h4xxel/sensys/project/rp/block.pdf

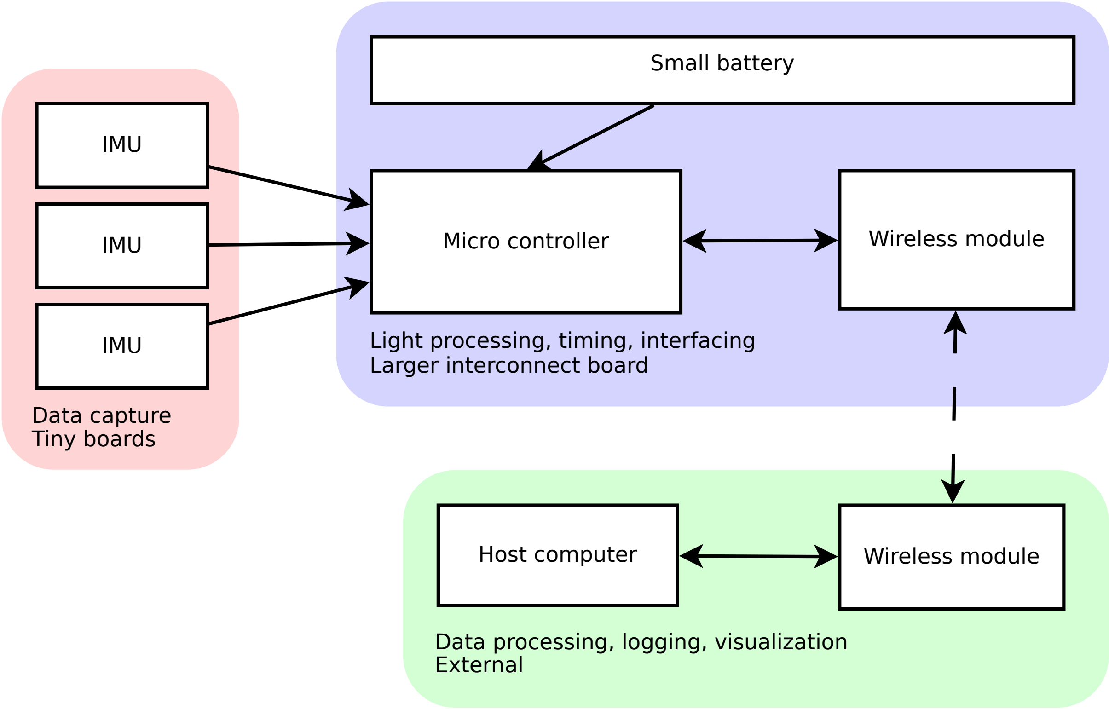
[picture p2: figure]
Host computer; Wireless module; Micro controller; IMU; Light processing, timing, interfacing; Data processing, logging, visualization; Data capture Tiny boards; Larger interconnect board; External; Small battery
