h4xxel/sensys/project/rp/fast_continuous.pdf

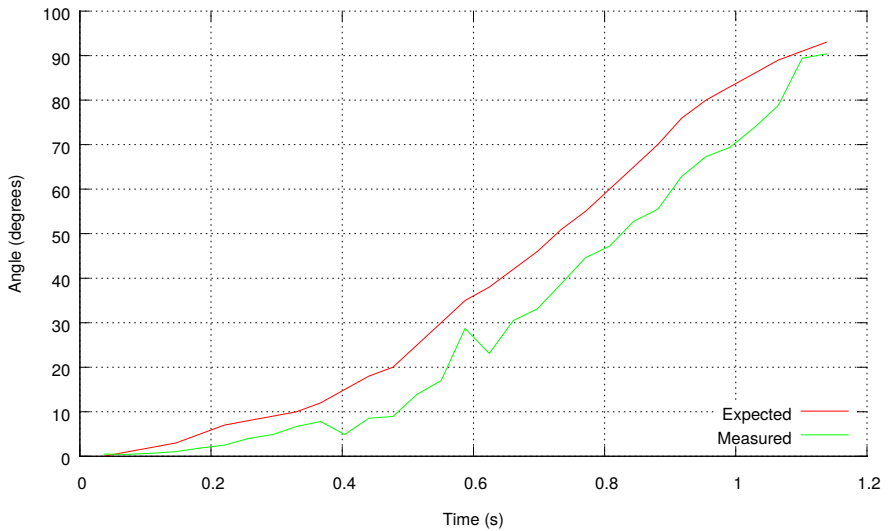
[picture p3: figure]
Angle (degrees); Time (s); Expected Measured
