h4xxel/sensys/project/rp/drift-test.txt

0: 2.754109, -5.791414, 1.912900
1: -2.135889, 3.678494, 3.380230
0: 3.484197, -5.737147, 0.786157
1: -2.248333, 3.543522, 8.210700
0: 3.324079, -6.429792, 2.592853
1: -1.999125, 3.940541, 8.957793
0: 3.663577, -6.534390, 3.165380
1: -2.439009, 4.077634, 16.534928
0: 3.523671, -6.586199, 3.595080
1: -2.739936, 4.635099, 22.509232
0: 4.181078, -6.275802, 4.041871
1: -3.190197, 4.027050, 18.898282
0: 3.587332, -6.578981, 8.183844
1: -2.313665, 4.399825, 36.857814
0: 3.763462, -6.266907, 9.407025
1: -2.519014, 4.058138, 40.708029
0: 4.041102, -6.453749, 13.049715
1: -2.561985, 4.053509, 41.313517
0: 4.044861, -6.879364, 14.176458
1: -2.894771, 4.844525, 46.248970
0: 4.060049, -6.381956, 18.270821
1: -3.555296, 4.817330, 49.063997
0: 3.740158, -7.006330, 14.310739
1: -2.608455, 4.893282, 51.717887
0: 4.591976, -6.848918, 21.376385
1: -4.256651, 4.655012, 51.041597
0: 3.910754, -7.464783, 22.722861
1: -3.404457, 5.141975, 51.788690
0: 4.214629, -6.475833, 24.950713
1: -4.033663, 3.994383, 51.944945
0: 4.015381, -6.854883, 29.198889
1: -3.103940, 4.664240, 43.468123
0: 3.746579, -7.061296, 31.819819
1: -2.875613, 4.813496, 30.856655
0: 4.352792, -6.191790, 39.698477
1: -3.066321, 3.819444, 25.315714
0: 3.803965, -6.847050, 44.513077
1: -3.302875, 4.025819, 26.403394
0: 4.499173, -6.910906, 46.259957
1: -4.105956, 4.755221, 25.305948
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
