h4xxel/sensys/project/pi/testbone.txt

0.24 0.12: 3 0, 3 0, 3 0, -1 0
0.24 0.12: 3 0, 3 0, 3 0, 0 1
