h4xxel/sensys/project/rp/drift.pdf

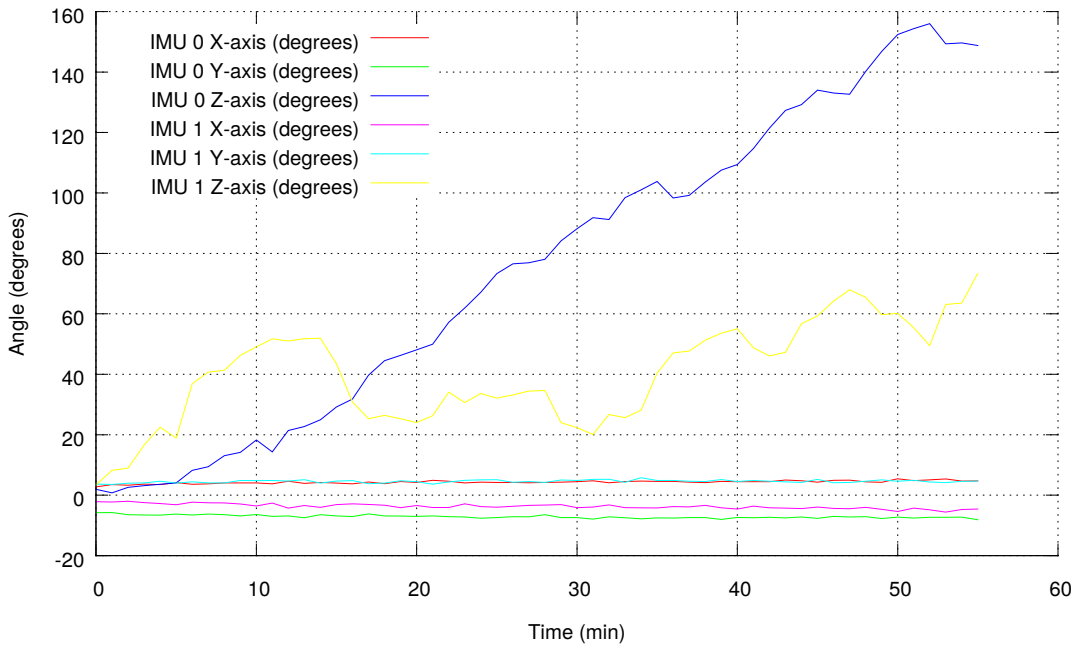
[picture p4: page 1]
Angle (degrees); Time (min)

IMU 0 X-axis (degrees)
IMU 0 Y-axis (degrees)
IMU 0 Z-axis (degrees)
IMU 1 X-axis (degrees)
IMU 1 Y-axis (degrees)
IMU 1 Z-axis (degrees)
