h4xxel/sensys/project/rp/mb_schematic.pdf

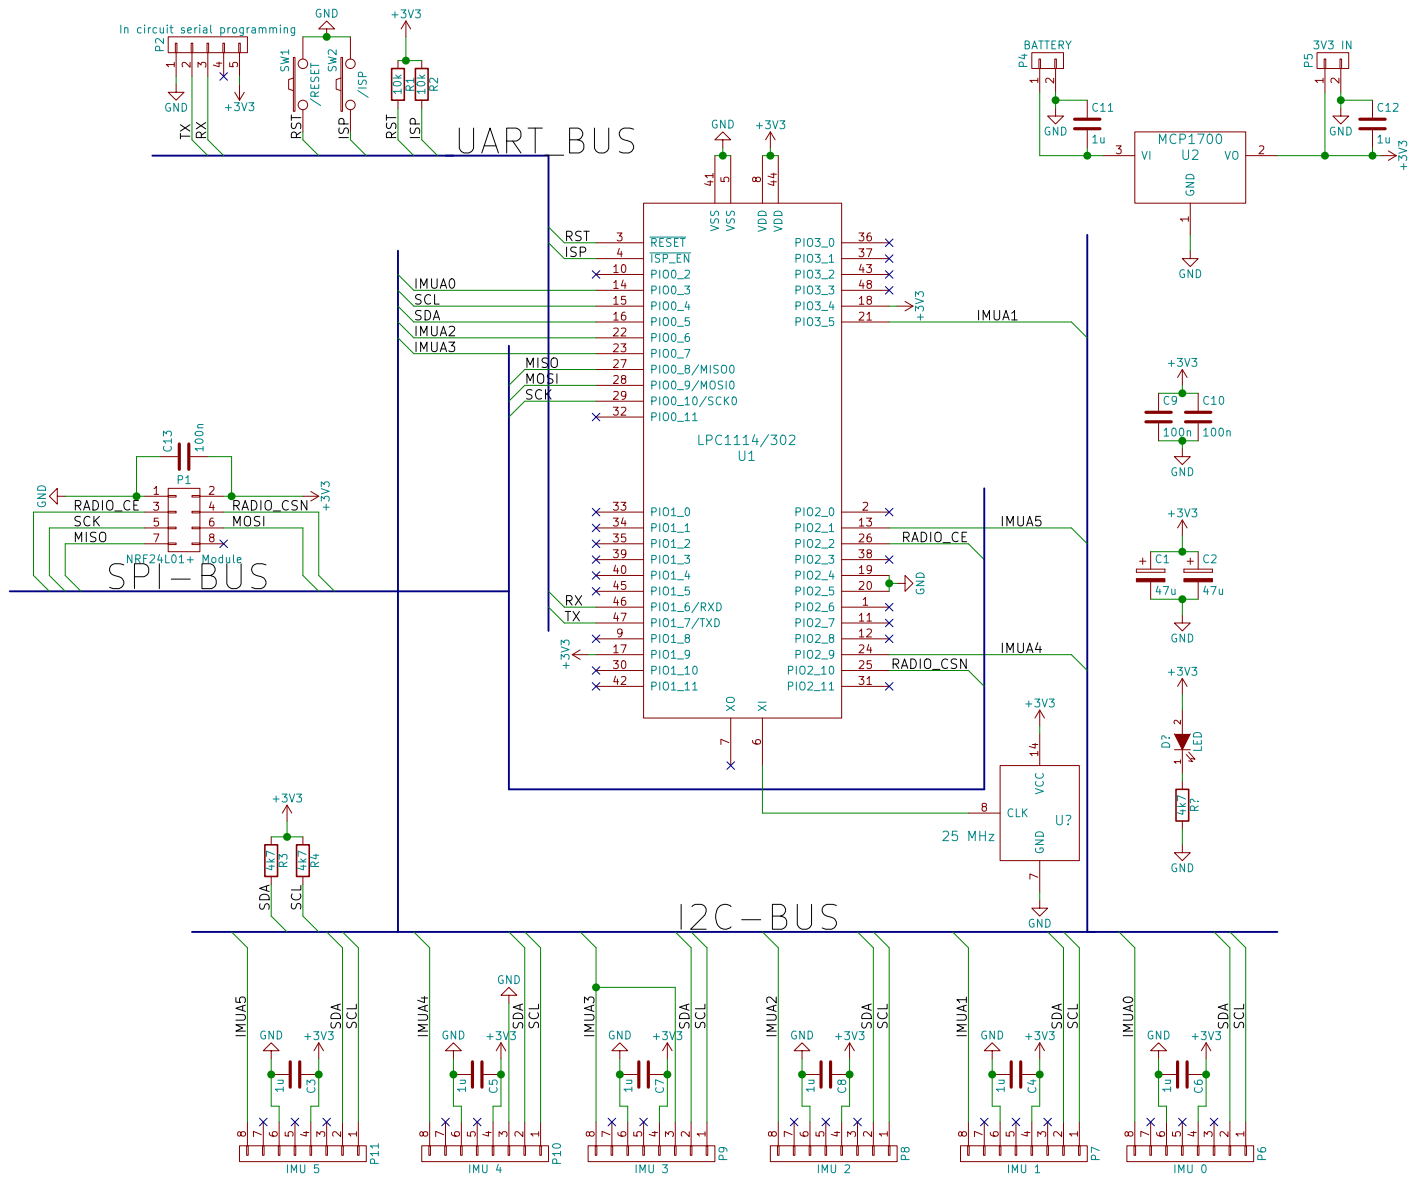
[picture p5: page 1]
