h4xxel/sensys/project/rp/imu_schematic.pdf

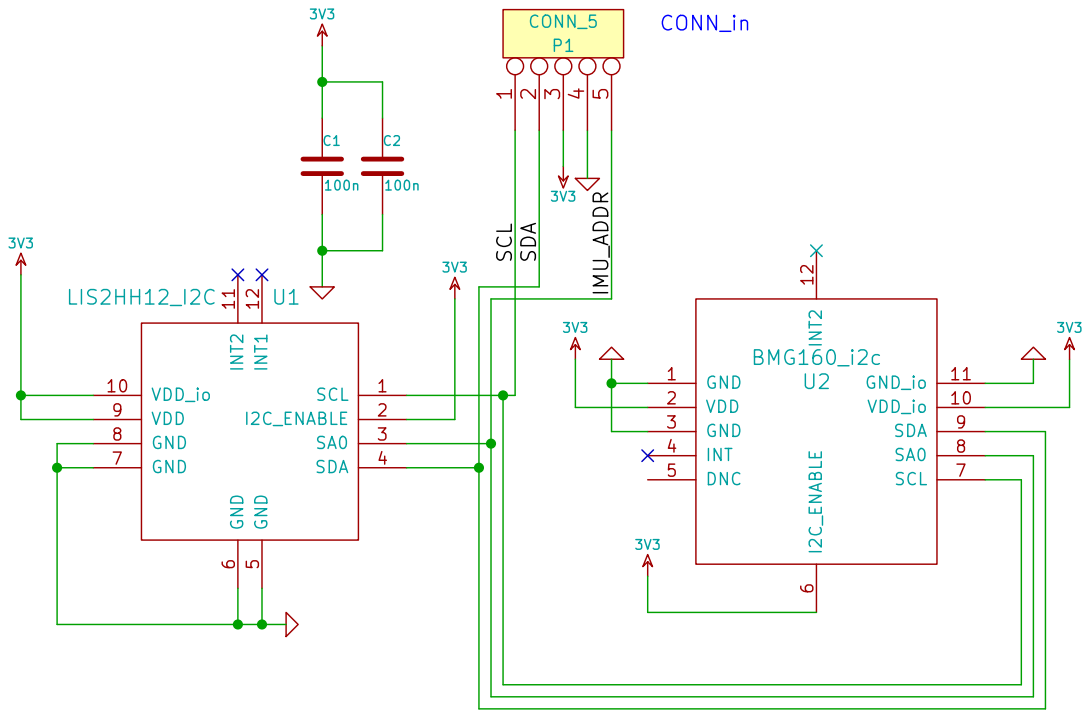
[picture p6: page 1]
