h4xxel/sensys/project/rp/micro-eps-converted-to.pdf

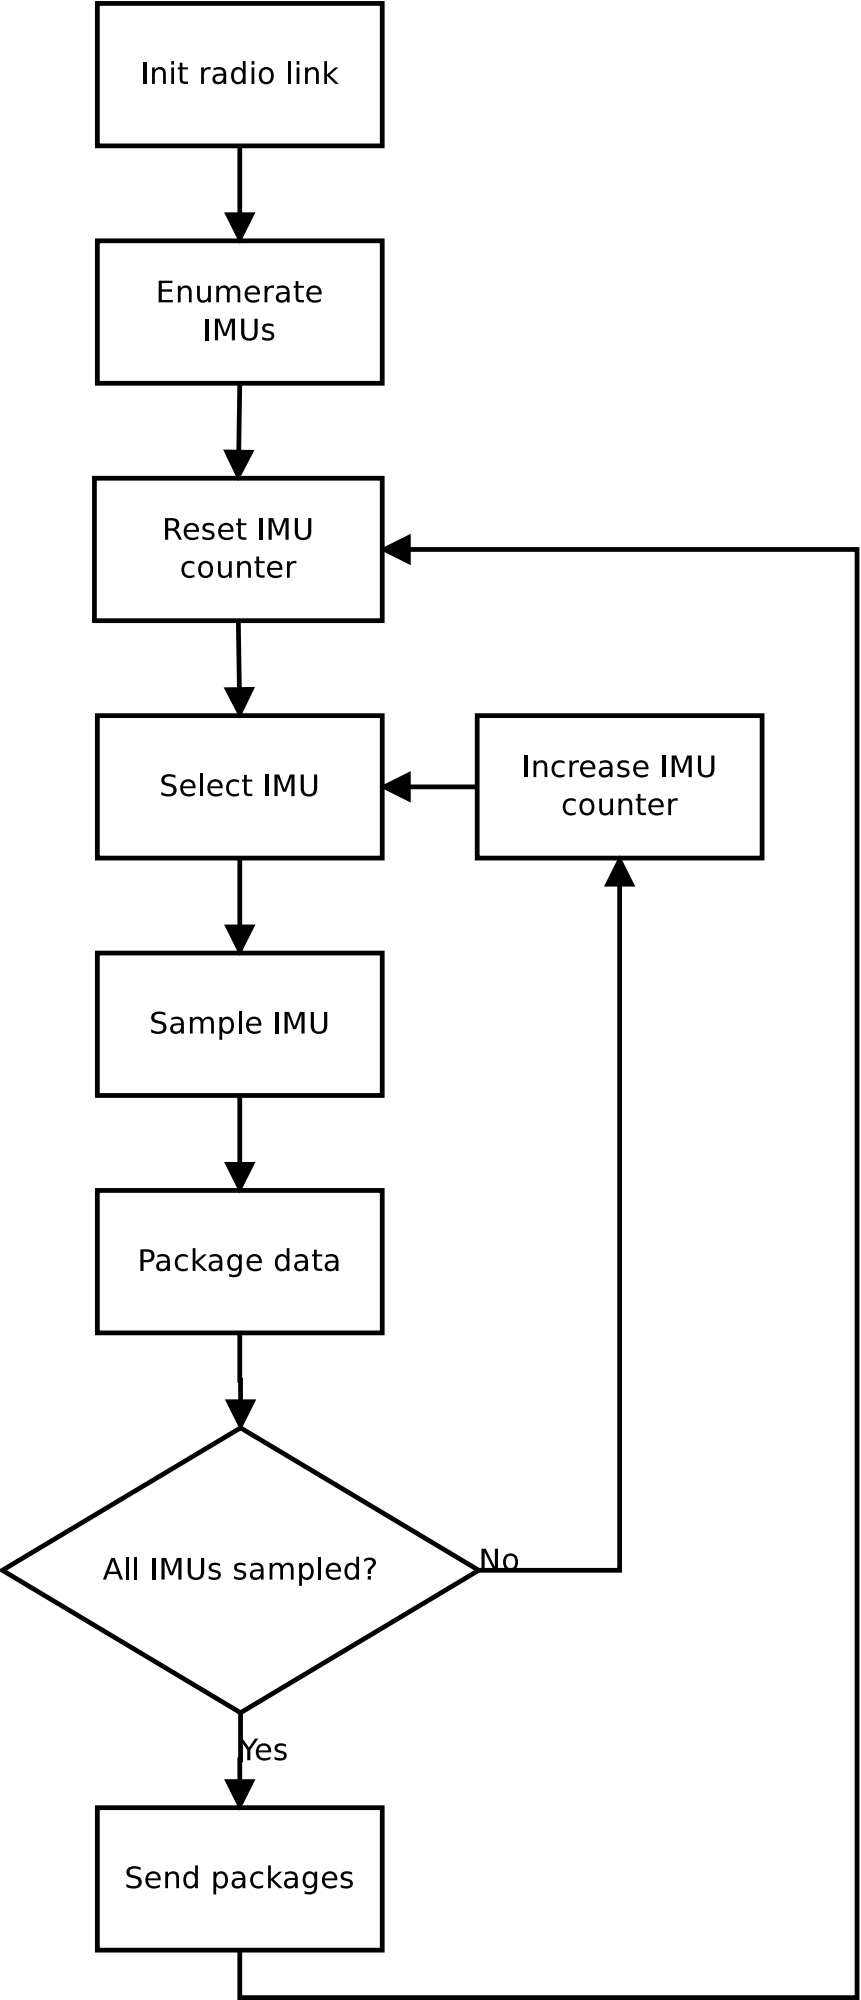
[picture p7: page 1]
