h4xxel/sensys/project/rp/pi-eps-converted-to.pdf

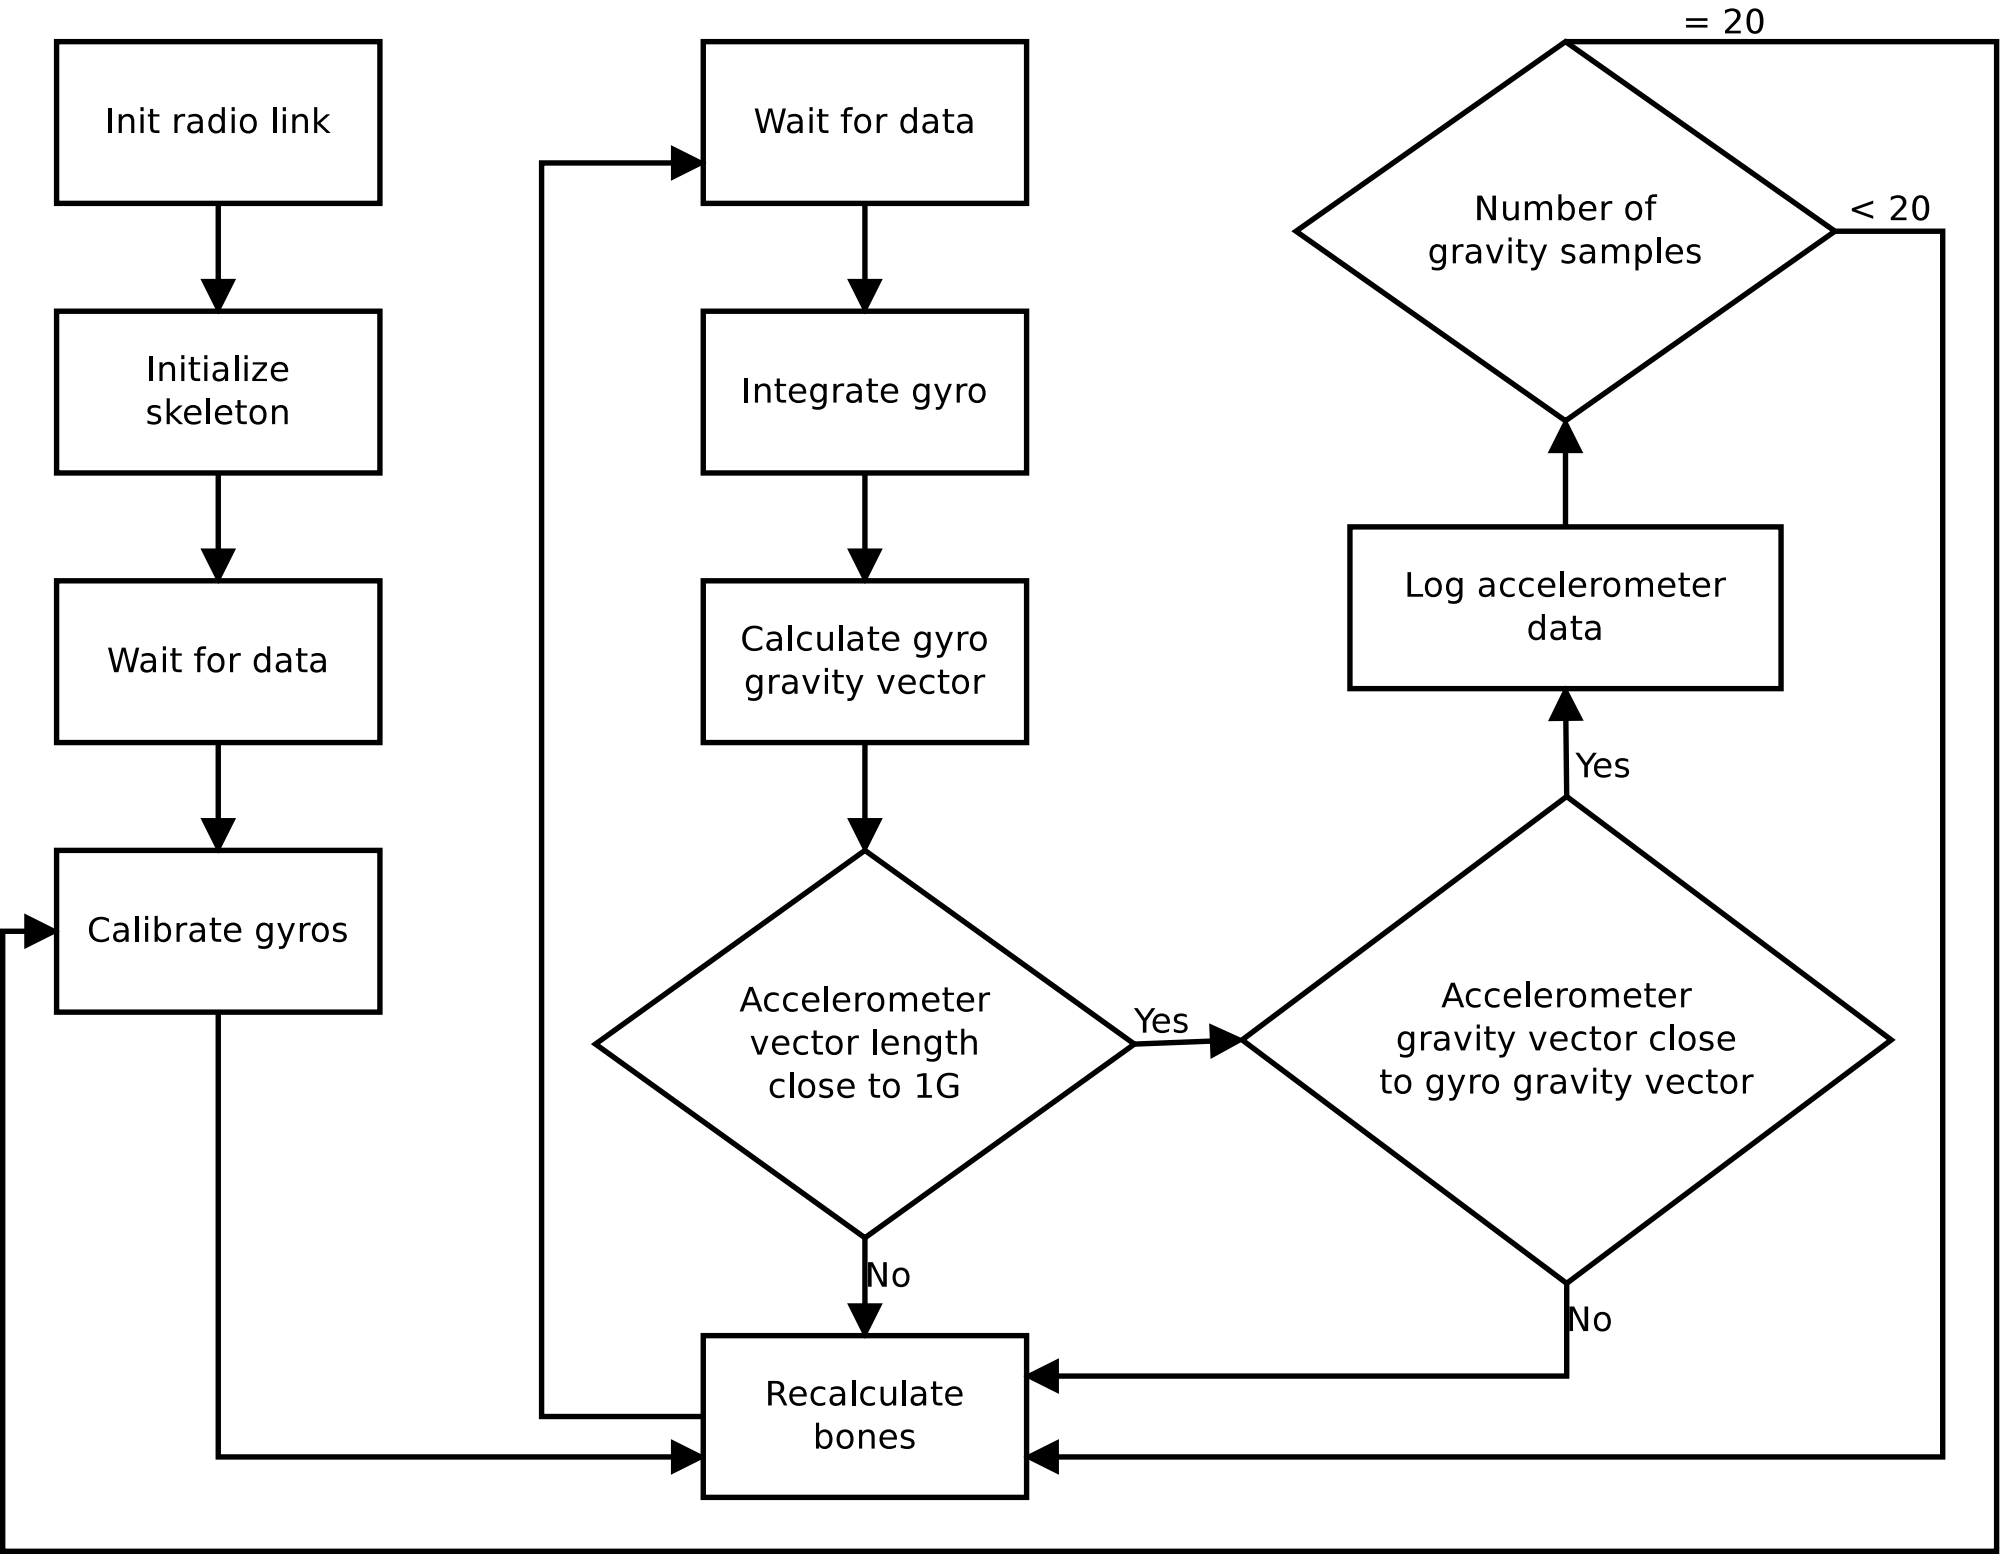
[picture p8: page 1]
