h4xxel/sensys/project/rp/stepped.pdf

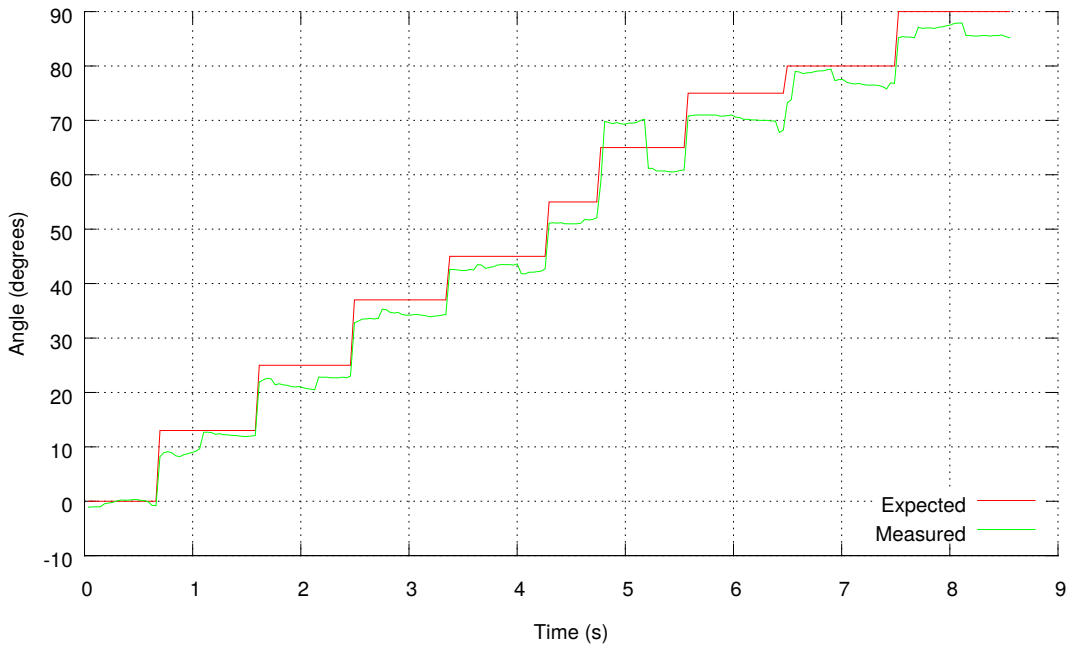
[picture p9: page 1]
Angle (degrees); Time (s); Expected Measured
