h4xxel/sensys/project/hw/imu/imu.kicad_pcb

## KiCad design project/hw/imu/imu.kicad_pcb (2015-12-17)

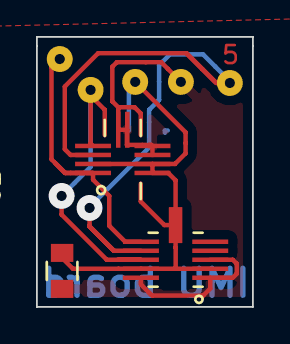
[picture p10: board imu.kicad_pcb from above]

Board: 2 copper layers, 12.0 x 15.0 mm, 5 parts (1 on the bottom side), 5 nets.

Parts:
C1, C2: 100n; C_0805
P1: CONN_5; Pin_Header_Straight_1x05
U1: LIS2HH12_I2C; LGA4x2
U2: BMG160_i2c; LGA5x1

Connections:
3V3: C1.1, C2.1, P1.3, U1.2, U1.9, U1.10, U2.2, U2.6, U2.10
GND: C1.2, C2.2, P1.4, U1.5, U1.6, U1.7, U1.8, U2.1, U2.3, U2.11
unnamed: P1.1, U1.1, U2.7
unnamed: P1.2, U1.4, U2.9
unnamed: P1.5, U1.3, U2.8
