h4xxel/sensys/project/hw/mb/mb.kicad_pcb

## KiCad design project/hw/mb/mb.kicad_pcb (2015-12-15)

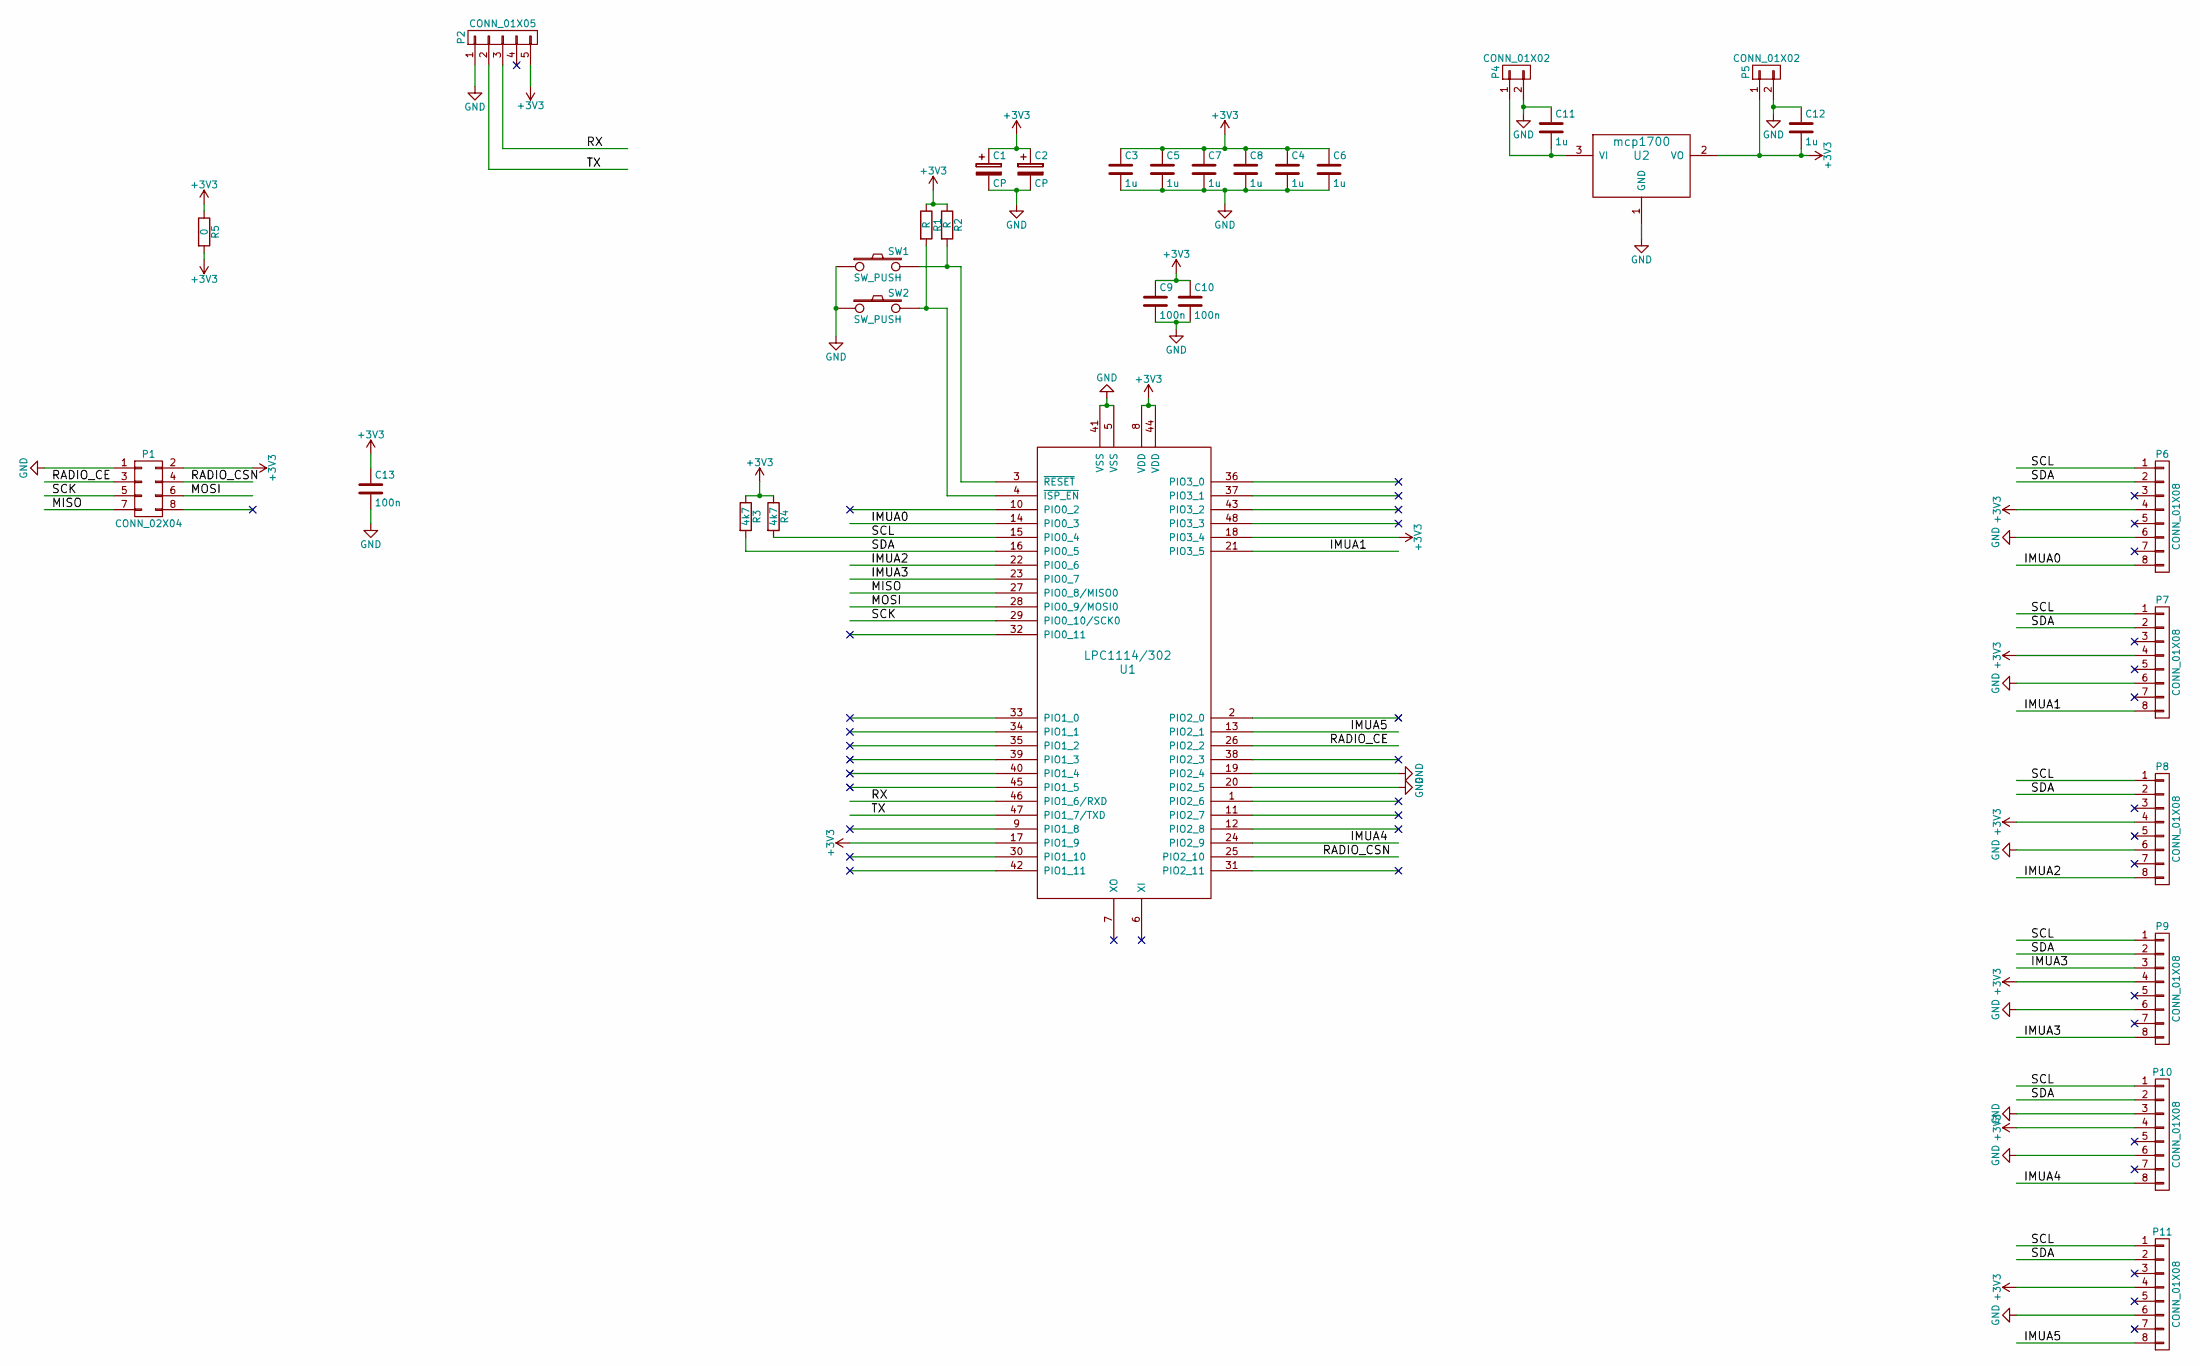
[picture p11: schematic mb.sch]

Parts:
C1, C2: CP; c_elec_4x5.7
C3, C4, C5, C6, C7, C8, C11, C12: 1u; C_1206_HandSoldering
C9, C10, C13: 100n; C_0805_HandSoldering
P1: CONN_02X04; Pin_Header_Straight_2x04
P2: CONN_01X05; Pin_Header_Straight_1x05
P4, P5: CONN_01X02; Pin_Header_Straight_1x02
P6, P7, P8, P9, P10, P11: CONN_01X08; Connector_Molex_PicoBlade_53398-0871
R1, R2: R; R_0805_HandSoldering
R3, R4: 4k7; R_0805_HandSoldering
R5: 0; R_1206_HandSoldering
SW1, SW2: SW_PUSH; SW_SPST_PTS645
U1: LPC1114/302; TQFP-48_7x7mm_Pitch0.5mm
U2: mcp1700; SOT-23_Handsoldering

Connections:
+3V3: C1.1, C2.1, C3.1, C4.1, C5.1, C6.1, C7.1, C8.1, C9.1, C10.1, C12.2, C13.1, P1.2, P2.5, P5.1, P6.4, P7.4, P8.4, P9.4, P10.4, P11.4, R1.1, R2.1, R3.1, R4.1, R5.1, R5.2, U1.8 (VDD), U1.17 (PIO1_9), U1.18 (PIO3_4), U1.44 (VDD), U2.2 (VO)
/IMUA0: P6.8, U1.14 (PIO0_3)
/IMUA1: P7.8, U1.21 (PIO3_5)
/IMUA2: P8.8, U1.22 (PIO0_6)
/IMUA3: P9.3, P9.8, U1.23 (PIO0_7)
/IMUA4: P10.8, U1.24 (PIO2_9)
/IMUA5: P11.8, U1.13 (PIO2_1)
/MISO: P1.7, U1.27 (PIO0_8/MISO0)
/MOSI: P1.6, U1.28 (PIO0_9/MOSI0)
/RADIO_CE: P1.3, U1.26 (PIO2_2)
/RADIO_CSN: P1.4, U1.25 (PIO2_10)
/RX: P2.3, U1.46 (PIO1_6/RXD)
/SCK: P1.5, U1.29 (PIO0_10/SCK0)
/SCL: P6.1, P7.1, P8.1, P9.1, P10.1, P11.1, R4.2, U1.15 (PIO0_4)
/SDA: P6.2, P7.2, P8.2, P9.2, P10.2, P11.2, R3.2, U1.16 (PIO0_5)
/TX: P2.2, U1.47 (PIO1_7/TXD)
GND: C1.2, C2.2, C3.2, C4.2, C5.2, C6.2, C7.2, C8.2, C9.2, C10.2, C11.1, C12.1, C13.2, P1.1, P2.1, P4.2, P5.2, P6.6, P7.6, P8.6, P9.6, P10.3, P10.6, P11.6, SW1.1, SW2.1, U1.5 (VSS), U1.19 (PIO2_4), U1.20 (PIO2_5), U1.41 (VSS), U2.1 (GND)
unnamed: C11.2, P4.1, U2.3 (VI)
unnamed: R1.2, SW2.2, U1.4 (~ISP_EN)
unnamed: R2.2, SW1.2, U1.3 (~RESET)

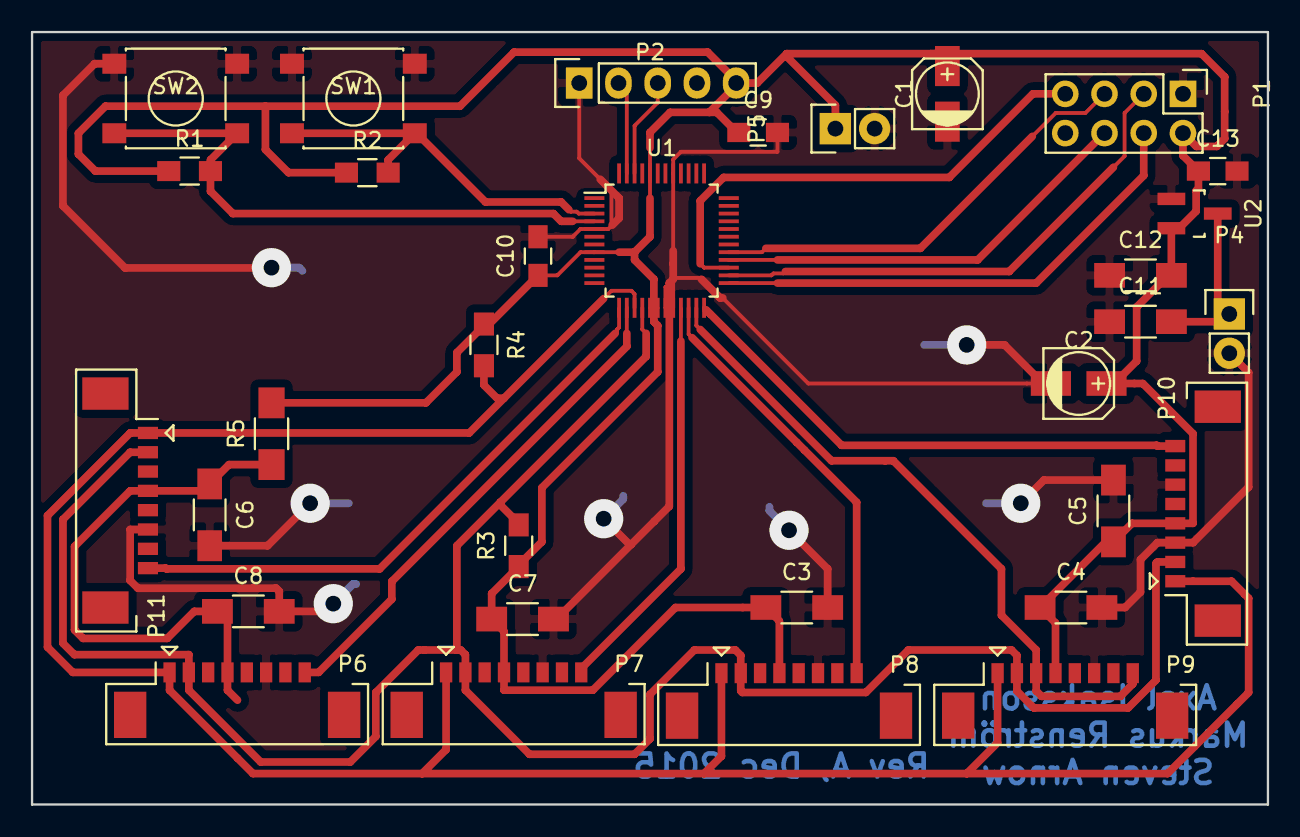
[picture p12: board mb.kicad_pcb from above]

Board: 2 copper layers, 80.0 x 50.0 mm, 32 parts (0 on the bottom side), 20 nets.
