h4xxel/sensys/project/sw/uart.c

#include <stdint.h>
#include <stdarg.h>
#include <limits.h>
#include "system/LPC11xx.h"
#include "uart.h"
#include "util.h"

#define MIN(a, b) ((a) < (b) ? (a) : (b))

void uart_init() {
	unsigned int regval;
	
	LPC_SYSCON->UARTCLKDIV = 1;
	/* Enable RXD, TXD on the IO pins */
	LPC_IOCON->PIO1_6 &= ~0x7;
	LPC_IOCON->PIO1_6 |= 1;
	LPC_IOCON->PIO1_7 &= ~0x7;
	LPC_IOCON->PIO1_7 |= 1;

	/* Enable UART clock bit */
	LPC_SYSCON->SYSAHBCLKCTRL |= (1 << 12);
	/* Set up FIFO */
	LPC_UART->FCR = 0x7;
	/* Set line control (stop bits etc.) */
	LPC_UART->LCR = 0x83;
	regval = ((SYSTEM_CLOCK/LPC_SYSCON->SYSAHBCLKDIV)/16/UART_BAUD_RATE);
	LPC_UART->FDR = 0x10;
	LPC_UART->DLL = regval & 0xFF;
	LPC_UART->DLM = (regval >> 8) & 0xFF;
	LPC_UART->LCR = 0x3;
}


void uart_send_char(unsigned char c) {
	while (!(LPC_UART->LSR & (1 << 5)));
	LPC_UART->THR = c;
}

void uart_send_raw(unsigned char *data, int bytes) {
	int i;
	for (i = 0; i < bytes; i++) {
		while (!(LPC_UART->LSR & (1 << 5)));
		LPC_UART->THR = data[i];
	}

	return;
}

void uart_send_string (char *s) {
	while(*s) {
		while (!(LPC_UART->LSR & (1 << 5)));
		LPC_UART->THR = *s++;
	}
}

void uart_send_hex(unsigned int data) {
	char out[8];
	int i/*, n*/;

	//n = 0;
	uart_send_string("0x");
	util_bin_to_str((void *) &data, out, 4);
	for (i = 7; i >= 0; i--) {
/*		if (out[i] == '0' && !n)
			continue;
		n = 1;*/
		uart_send_raw((unsigned char *) &out[i], 1);
	}

	/*if (out[0] == '0')
		uart_send("0", 1);*/
	uart_send_string(" ");

	return;
}

static char *int_to_string(unsigned long long int n, char *s, int base) {
	char i;
	do {
		s--;
		i = n  % base;
		i += (i > 9 ? 'A' - 10 : '0');
		*s = i;
		n /= base;
	} while(n);
	return s;
}

int uart_vprintf(char *format, va_list va) {
	unsigned char pad, c;
	int i;
	unsigned int j;
	unsigned long long int num = 0;
	signed long long int signum = 0;
	
	enum {
		LENGTH_CHAR,
		LENGTH_SHORT,
		LENGTH_INT,
		LENGTH_LONG,
		LENGTH_LONG_LONG,
		LENGTH_INTMAX_T,
		LENGTH_SIZE_T,
		LENGTH_PTRDIFF_T,
	} length;
	int width;
	char prefix, base, *s;
	char buf[25];
	buf[24] = 0;
	
	for(i=0; (c = *format++); i++) {
		if(c != '%') {
			uart_send_char(c);
			continue;
		}
		length = LENGTH_INT;
		width = 0;
		prefix = 0;
		pad = ' ';
		base = 10;
		
		while(1) {
			switch(c = *format++) {
				case 0:
					goto end;
				case '%':
					uart_send_char(c);
					goto next;
				case '#':
					prefix = 1;
					break;
				case '0':
					if(!width) {
						pad = '0';
						break;
					}
				case '1': case '2': case '3': case '4':
				case '5': case '6': case '7': case '8': case '9':
					width = width*10 + (c - '0');
					break;
				case 'h':
					length = length == LENGTH_SHORT ? LENGTH_CHAR : LENGTH_SHORT;
					break;
				case 'l':
					length = length == LENGTH_LONG ? LENGTH_LONG_LONG : LENGTH_LONG;
					break;
				case 'j':
					length = LENGTH_INTMAX_T;
					break;
				case 'z':
					length = LENGTH_SIZE_T;
					break;
				case 't':
					length = LENGTH_PTRDIFF_T;
					break;
				case 'o':
					base = 8;
					if(prefix)
						uart_send_char('0');
					goto baseconv;
				case 'p':
					length = sizeof(void *);
					prefix = 1;
				case 'x':
				case 'X':
					base = 16;
					if(prefix)
						uart_send_string("0x");
				case 'u':
					baseconv:
					switch(length) {
						case LENGTH_CHAR:
							num = (unsigned char) va_arg(va, unsigned int);
							break;
						case LENGTH_SHORT:
							num = (unsigned short) va_arg(va, unsigned int);
							break;
						case LENGTH_INT:
							num = (unsigned int) va_arg(va, unsigned int);
							break;
						case LENGTH_LONG:
							num = (unsigned long) va_arg(va, unsigned long);
							break;
						case LENGTH_LONG_LONG:
							num = (unsigned long long) va_arg(va, unsigned long long);
							break;
						default:
							break;
					}
					goto print_num;
				case 'd':
				case 'i':
					switch(length) {
						case LENGTH_CHAR:
							signum = (signed char) va_arg(va, signed int);
							break;
						case LENGTH_SHORT:
							signum = (signed short) va_arg(va, signed int);
							break;
						case LENGTH_INT:
							signum = (signed int) va_arg(va, signed int);
							break;
						case LENGTH_LONG:
							signum = (signed long) va_arg(va, signed long);
							break;
						case LENGTH_LONG_LONG:
							signum = (signed long long) va_arg(va, signed long long);
							break;
						default:
							break;
					}
					if(signum < 0) {
						uart_send_char('-');
						num = -signum;
					} else
						num = signum;
					goto print_num;
				case 's':
					uart_send_string(va_arg(va, char *));
					goto next;
				case 'c':
					uart_send_char((char) va_arg(va, int));
					goto next;
			}
		}
		print_num:
		s = int_to_string(num, buf + 24, base);
		j = 24 + buf - s;
		if(!width)
			width = j;
		else
			while(width > j)  {
				uart_send_char(pad);
				width--;
			}
		uart_send_raw((unsigned char *) s, width);
		next:;
	}
	end:
	return i;
}

int uart_printf(char *format, ...) {
	int ret;
	va_list va;
	va_start (va, format);
	ret = uart_vprintf(format, va);
	va_end(va);
	return ret;
}



uint8_t uart_recv_char(void) {
	while(!(LPC_UART->LSR & 1));
	return LPC_UART->RBR;
}


void uart_recv_raw(unsigned char *buff, int bytes) {
	int i;

	for (i = 0; i < bytes; i++) {
		buff[i] = uart_recv_char();
		//uart_printf("arne 0x%X\n", buff[i]);
	}
	return;
}


uint16_t uart_recv_try(void) {
	if (LPC_UART->LSR & 1)
		return LPC_UART->RBR | 0x100;
	return 0;
}
