h4xxel/sensys/(commit log)

2015-12-02 slide measurements when timing using computer
    [slide_measurment_computer_timing.csv]
2015-12-10 i2c is working
2015-12-10 motherboard cad
2015-12-11 imu pcb
2015-12-15 motherboard design done
    [mb.kicad_pcb, mb.sch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]
2015-12-16 test for imu board
2015-12-17 motherboard read gyro
2015-12-17 get gyro in degrees
2016-01-09 sample IMU data
2016-01-09 Raw data display with angle reset button
2016-01-11 Started on bones, fixed pigl
    [bone.c, gl.h, pc-gl.c, pi-gl.c, thread.c, triangle.c]
2016-01-11 rotate camera
2016-01-11 Maybe possibly that it snaps absolute position to calculated thingomabobs
    [bone.c, bone.h, main.c, triangle.c, vector.h]
2016-01-12 added clean exit with esc
2016-01-12 more broken linear algebra
    [pc-gl.c, pi-gl.c, thread.c, triangle.c]
2016-01-12 added camera zoom
2016-01-13 print camera pos
2016-01-13 Actually print camera
2016-01-13 set gyro
2016-01-13 Print correct camera values
    [triangle.c]
2016-01-13 reset first imu sample
    [thread.c]
2016-01-13 Press 'r' to reset radio link
    [bogus.c, thread.c]
2016-01-13 set gyro working fucking finally
2016-01-14 average accelerometers
2016-01-14 auto recal gyros
2016-01-15 replaced radio with serial for now
    [imu.c, main.c]
2016-01-15 add key to print bone angles
2016-01-16 Wë́'ll mesure stuff and things
2016-01-16 data 1 added
    [Data1.csv]
2016-01-16 data2 added
    [Data2.csv]
2016-01-16 imu schematic, plot scripts
    [drift-0.csv, drift-1.csv]
2016-01-16 Power usage
2016-01-17 better description of sensors
2016-01-17 explained the gyro calculation algorithm
2016-01-17 added appendix data
    [Data1-comma.csv, Data2-comma.csv, drift-0-header.csv, drift-1-header.csv]
